fumiama/stm32-seesaw/Core/Src/main.c

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
/* Includes ------------------------------------------------------------------*/
#include "main.h"

/* USER CODE BEGIN Includes */
#include <stdio.h>
#include <math.h>
/* USER CODE END Includes */

/* USER CODE BEGIN PD */
#define GY_ACC 0x15
#define GY_RO  0x25
#define GY_MG  0x35
#define GY_EUR 0x45
#define GY_4P  0x65
#define GY_ACF 0x75
#define GY_RNG 0x85

#define GY_T_ACC "\xa5\x15\xba"
#define GY_T_RO  "\xa5\x25\xca"
#define GY_T_MG  "\xa5\x35\xda"
#define GY_T_EUR "\xa5\x45\xea"
#define GY_T_4P  "\xa5\x65\x0a"

#define GY_G_RO  "\xa5\xd5\x7a"
#define GY_G_MG  "\xa5\xe5\x8a"
#define GY_G_EUR "\xa5\x95\x3a"

#define GY_FIX_ACC "\xa5\x57\xfc"
#define GY_FIX_MG  "\xa5\x58\xfd"

#define GY_SPED_50 "\xa5\xa4\x49"

#define CMD_FRNT  '^'
#define CMD_BACK  'v'
#define CMD_LEFT  '<'
#define CMD_RGHT  '>'
#define CMD_STAT  '#'
#define CMD_STOP  '-'
#define CMD_LOCK  '+'

#define RO_RATE CIRCLE_TICKS

#define CALC_SPEED_PIHEDGE 16

#define PID_KP 0.04f
#define PID_KI 0.0f
#define PID_KD 0.09f
#define PID_KPS 0.03f
#define PID_KIS 0.0f
#define PID_KDS 0.08f
/* USER CODE END PD */

TIM_HandleTypeDef htim1;

UART_HandleTypeDef huart1;
UART_HandleTypeDef huart2;

/* USER CODE BEGIN PV */
uint8_t     USART1_SendBuff[USART1_SEND_LEN_MAX];
uint8_t     USART1_RecvBuff[USART1_RECV_LEN_MAX];
uint8_t     UserRecvBuff1[USART1_RECV_LEN_MAX];

uint8_t     USART2_SendBuff[USART2_SEND_LEN_MAX];
uint8_t     USART2_RecvBuff[USART2_RECV_LEN_MAX];
//uint8_t     UserRecvBuff2[USART2_RECV_LEN_MAX];

/**********GY953的相关变量*********/
/*
int16_t   AccX       = 0;		//加速度值
int16_t   AccY       = 0;
int16_t   AccZ       = 0;

int16_t   GyroX      = 0;		//陀螺仪值
// y 小于 0 说明有向下转动的角加速度
int16_t   GyroY      = 0;
int16_t   GyroZ      = 0;

int16_t   MgX	    	 = 0;   //地磁计值
int16_t   MgY        = 0;
int16_t   MgZ        = 0;

int16_t   Roll       = 0;		//欧拉角值*100
*/
// pitch 小于 0 说明向下倾斜
//int16_t   Pitch      = 0;
//int16_t   Yaw        = 0;

BTSTAT bs;
int16_t speed1 = 50, speed2 = 24, tick = CIRCLE_TICKS-64, eurcntr = 0;
uint8_t isunstable = 0, isinpid = 0, isinit = 0;
static uint8_t isonexit = 0, isindiradj = 1;
static int16_t pmid = 0, pgnd = 0, ymid = 0, prevp = 0;
/* USER CODE END PV */

void SystemClock_Config(void);
static void MX_GPIO_Init(void);
static void MX_TIM1_Init(void);
static void MX_USART1_UART_Init(void);
static void MX_USART2_UART_Init(void);
/* USER CODE BEGIN PFP */
static int16_t Calc_PID(int16_t y);
static int Calc_Speed(int16_t y);
static int Calc_Direction(int16_t z);
/* USER CODE END PFP */

/**
  * @brief  The application entry point.
  * @retval int
  */
int main(void)
{
  /* MCU Configuration--------------------------------------------------------*/

  /* Reset of all peripherals, Initializes the Flash interface and the Systick. */
  HAL_Init();

  /* Configure the system clock */
  SystemClock_Config();

  /* Initialize all configured peripherals */
  MX_GPIO_Init();
  MX_TIM1_Init();
  MX_USART1_UART_Init();
  MX_USART2_UART_Init();
  /* USER CODE BEGIN 2 */
  HAL_TIM_PWM_Start(&htim1, TIM_CHANNEL_1);
  HAL_TIM_PWM_Start(&htim1, TIM_CHANNEL_4);
  
  // UART1 串口1 开启接收中断，存到USART1_RecvBuff中，最大长度为 USART1_RECV_LEN_MAX
  // 即，接收了 USART1_RECV_LEN_MAX 个数据之后，产生中断
  // 中断将会触发 HAL_UART_RxCpltCallback 串口接收中断处理函数    
  HAL_UART_Receive_IT(&huart1, (uint8_t *)USART1_RecvBuff, USART1_RECV_LEN_MAX);
  // UART2 串口2 同理
  HAL_UART_Receive_IT(&huart2, (uint8_t *)USART2_RecvBuff, USART2_RECV_LEN_MAX);

  MotoCtrl_SetValue(0, MOTOR_ALL);
  HAL_Delay(1024);
  GY_UART_Init();
  /* USER CODE END 2 */

  /* Infinite loop */
  /* USER CODE BEGIN WHILE */
  while (1) {
    /* USER CODE END WHILE */

    /* USER CODE BEGIN 3 */
    __WFI();
  }
  /* USER CODE END 3 */
}

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
/* USER CODE BEGIN 4 */
/* ！！！！！！！！务必在  USER CODE BEGIN  和 USER CODE END 之间添加用户程序！！！！！！！！*/
/* ！！！！！！！！！而且不要改动   USER CODE BEGIN 4   之类的标记！！！！！！！！！！！！！*/
//
// MotoCtrl_SetValue 圆周舵机的转速控制设置函数
//
// value 转速设置值，-200 ~ 200，大约在 0 左右转速为 0
//       正转，反转
//       如果超出 -200 ~ 200 范围，不进行设置
//
// motor 电机号，MOTOR_1 或 MOTOR_2，在main.h中有定义
//       MOTOR_1 用的是htim1的TIM_CHANNEL_1，用 PA8 端口
//       MOTOR_2 用的是htim1的TIM_CHANNEL_4，用 PA11 端口
static TIM_OC_InitTypeDef sConfig = {TIM_OCMODE_PWM1, 0, TIM_OCPOLARITY_HIGH, TIM_OCNPOLARITY_HIGH, TIM_OCFAST_DISABLE, TIM_OCIDLESTATE_RESET, TIM_OCNIDLESTATE_RESET};
void MotoCtrl_SetValue(int16_t value, int16_t motor) {
    // 转速设置范围判断
    if ((value>200)||(value<-200)) return;
    TIM_OC_InitTypeDef sConfigOC = sConfig;

    if ( motor==MOTOR_2 || !~motor ){
      // 实际设置PWM的值是 100 - 500
      sConfigOC.Pulse = value+300;
      HAL_TIM_PWM_Stop(&htim1, TIM_CHANNEL_1);
    	if (HAL_TIM_PWM_ConfigChannel(&htim1, &sConfigOC, TIM_CHANNEL_1) != HAL_OK) Error_Handler();
    	HAL_TIM_PWM_Start(&htim1, TIM_CHANNEL_1);
    }

    if ( motor==MOTOR_1 || !~motor ){
      // 实际设置PWM的值是 100 - 500
      sConfigOC.Pulse = -value+300;
    	HAL_TIM_PWM_Stop(&htim1, TIM_CHANNEL_4);
      if (HAL_TIM_PWM_ConfigChannel(&htim1, &sConfigOC, TIM_CHANNEL_4) != HAL_OK) Error_Handler();
      HAL_TIM_PWM_Start(&htim1, TIM_CHANNEL_4);
    }
}

void GY_UART_Init(void) {
  HAL_UART_Transmit_IT(&huart1,  (uint8_t*)(GY_T_EUR GY_FIX_ACC), sizeof(GY_T_EUR GY_FIX_ACC)-1);
  HAL_UART_Transmit_IT(&huart2, (uint8_t*)"[Init] GY to eur.\n", 18);
}

void GY_UART_Switch(void) {
  HAL_UART_Transmit_IT(&huart1, (uint8_t*)(GY_T_EUR GY_T_RO), sizeof(GY_T_EUR GY_T_RO)-1);
}

void GY_UARTPackage_Unpack(void) {
  static int16_t stables = 0;
  static uint8_t not_frist_init = 0;
  GY953Frame* gf = (GY953Frame*)UserRecvBuff1;
  unsigned char s = 0;
  for(s = 0; s < USART1_RECV_LEN_MAX-5; s++) {
    if(gf->Head != 0x5a5a) gf = (GY953Frame*)(UserRecvBuff1+s);
    else break;
  }
  if(s == USART1_RECV_LEN_MAX-5) return;
  unsigned char* rawd = gf->RawData;
  int16_t speed, tmod;
  char sndbuf[256];
  sndbuf[0] = 0;
  //int16_t X = __builtin_bswap16(*(uint16_t*)(rawd));
  int16_t Y = __builtin_bswap16(*(uint16_t*)(rawd+2));
  int16_t Z = __builtin_bswap16(*(uint16_t*)(rawd+4));
  switch(gf->Type) {
    case GY_ACC:
      //AccX = X; AccY = Y; AccZ = Z;
      //HAL_UART_Transmit_IT(&huart2, (uint8_t*)"recv acc.\n", 10);
    break;
    case GY_RO:
      //GyroX = X; GyroY = Y; GyroZ = Z;
      //HAL_UART_Transmit_IT(&huart2, (uint8_t*)"recv ro.\n", 9);
      if(!isinit) return;
      if(!isinpid) {
        if(Y>RO_RATE||Y<-RO_RATE) {
          stables = 0;
          if(!isunstable) {
            isunstable = 1;
            MotoCtrl_SetValue(0, MOTOR_ALL);
            HAL_UART_Transmit_IT(&huart2, (uint8_t*)"[State] unstable.\n", 18);
            if(!not_frist_init) not_frist_init = 1;
            tick = CIRCLE_TICKS-64;
          }
        } else if(isunstable) {
          if(stables++>64) {
            isunstable = stables =  0;
            HAL_UART_Transmit_IT(&huart2, (uint8_t*)"[State] stable.\n", 16);
          }
        } else if(not_frist_init && !bs.isstarted) {
          tmod = tick++&(CIRCLE_TICKS-1);
          if(tmod==CIRCLE_TICKS>>1) {
            MotoCtrl_SetValue(0, MOTOR_ALL);
            sprintf(sndbuf, "[GyUR] stop motor.\n");
          } else if(tmod==CIRCLE_TICKS-64) {
            GY_UART_Switch();  // 切换到 EUR
            sprintf(sndbuf, "[GyUR] switch to eur.\n");
          }
        }
      }
    break;
    case GY_MG:
      //MgX = X; MgY = Y; MgZ = Z;
      //HAL_UART_Transmit_IT(&huart2, (uint8_t*)"recv mg.\n", 9);
    break;
    case GY_EUR:
      //Roll = X; Pitch = Y; Yaw = Z;
      if(isonexit) {
        if(~isonexit) {
          if(isonexit>64) {
            tmod = Y-pgnd;
            if(tmod>-4&&tmod<4) {
              tmod = 0;
              isonexit = -1;
              speed1 = 50; speed2 = 24;
              MotoCtrl_SetValue(0, MOTOR_ALL);
              sprintf(sndbuf, "[GyUR] program finished.\n");
            }
          } else isonexit++;
        } else HAL_GPIO_TogglePin(LED_IDC_GPIO_Port, LED_IDC_Pin); // 灯闪
      }
      if(!isinit) {
        if(~eurcntr) {
          if(!eurcntr) {
            if(Y) eurcntr++;
          }
          if(eurcntr) {
            if(eurcntr == 64) {
              pmid = Y; ymid = Z;
              sprintf(sndbuf, "[GyUR] init pmid: %d, ymid: %d.\n", Y, Z);
            } else if(eurcntr > 64) {
              pmid = (pmid+Y)/2;
              ymid = (ymid+Z)/2;
            }
            if(eurcntr++>128) {
              pgnd = pmid;
              sprintf(sndbuf, "[GyUR] fin pmid: %d, ymid: %d.\n", pmid, ymid);
              HAL_GPIO_TogglePin(LED_IDC_GPIO_Port, LED_IDC_Pin); // 灯灭
              eurcntr = -1;
            }
          }
        }
      }
      else if(isindiradj) {
        if(Y-pmid>256) { // 抬头
          if(Calc_Direction(Z)) { // 回归正向
            isindiradj = 0;
            GY_UART_Switch(); // 切换到 RO
            sprintf(sndbuf, "[GyUR] quit dir, switch to ro.\n");
          }
          MotoCtrl_SetValue(speed1, MOTOR_1);
          MotoCtrl_SetValue(speed2, MOTOR_2);
        }
      }
      else if(isinpid) {
        speed = Calc_PID(Y);
        if(speed>-8&&speed<8) {
          if(stables++>500) { // 保持 10s
            isinpid = stables = isinit = prevp = 0;
            isonexit = 1;
            speed1 = 50; speed2 = 24;
            MotoCtrl_SetValue(-speed1, MOTOR_1);
            MotoCtrl_SetValue(-speed2, MOTOR_2);
            sprintf(sndbuf, "[GyUR] quit pid, on exit.\n");
          }
          HAL_GPIO_TogglePin(LED_IDC_GPIO_Port, LED_IDC_Pin); // 灯闪
        } else {
          stables = 0;
          sprintf(sndbuf, "[GyUR] speed: %d.\n", speed);
          if(speed>10||speed<-10) {
            MotoCtrl_SetValue(speed, MOTOR_ALL);
          } else {
            MotoCtrl_SetValue(speed+4, MOTOR_1);
            MotoCtrl_SetValue(speed-4, MOTOR_2);
          }
        }
      }
      else if(not_frist_init && !bs.isstarted && !isunstable) {
        tmod = tick++&(CIRCLE_TICKS-1);
        if(!tmod) {
          isinpid = Calc_Speed(Y);
          if(!isinpid) {
            GY_UART_Switch();  // 切换到 RO
            MotoCtrl_SetValue(speed1, MOTOR_1);
            MotoCtrl_SetValue(speed2, MOTOR_2);
            sprintf(sndbuf, "[GyUR] switch to ro.\n");
          } else {
            MotoCtrl_SetValue(0, MOTOR_ALL);
            stables = 0;
            sprintf(sndbuf, "[GyUR] enter into pid.\n");
          }
        }
      }
      //HAL_UART_Transmit_IT(&huart2, (uint8_t*)"recv eur.\n", 10);
    break;
    default: break;
  }
  int sndlen = strlen(sndbuf) + 1;
  if(sndlen > 1) HAL_UART_Transmit_IT(&huart2, (uint8_t*)sndbuf, sndlen);
}

static int16_t Calc_PID(int16_t y) {
  static int16_t prev_dy = 0, int_sum = 0;
  static uint8_t stables = 0;
  int16_t dy = y - pmid, out;
  int_sum += dy;
  if(stables>128) {
    out = PID_KPS*(float)dy + PID_KIS*(float)int_sum + PID_KDS*(float)(dy-prev_dy);
  } else {
    out = PID_KP*(float)dy + PID_KI*(float)int_sum + PID_KD*(float)(dy-prev_dy);
    if(out>=-2&&out<=2) stables++;
    else stables = 0;
  }
  prev_dy = dy;
  return out;
}

static int Calc_Direction(int16_t z) {
  int16_t ds, s1, s2, dz = z-ymid;
  if(dz>-16&&dz<16) {
    speed1 = 50; speed2 = 24;
    return 1;
  }
  if(dz>0) {
    ds = 1.2*sqrt(dz);
    s1 = -ds+20;
    s2 = ds+20;
  } else {
    ds = 1.2*sqrt(-dz);
    s1 = ds+20;
    s2 = -ds+20;
  }
  ds = s1-speed1;
  if(ds>10) speed1 += 10;
  else if(ds<-10) speed1 -= 10;
  ds = s2-speed2;
  if(ds>10) speed2 += 10;
  else if(ds<-10) speed2 -= 10;
  return 0;
}

int Calc_Speed(int16_t y) {
  char sndbuf[256];
  sndbuf[0] = 0;
  if(!prevp) prevp = y;
  else {
    pmid = (prevp+y)/2;
    prevp = y;
    return 1;
  }
  int16_t dp = y-pmid;
  y = 0;
  int16_t d1 = 0, d2 = 0;
  if(dp<-CALC_SPEED_PIHEDGE||dp>CALC_SPEED_PIHEDGE) {
    if(dp > 0) {
      d1=50; d2=24;
    }
    else {
      d1=-50; d2=-24;
    }
  }
  speed1 = d1;
  speed2 = d2;
  sprintf(sndbuf, "[Calc] pmid: %d, dp: %d.\n", pmid, dp);
  int sndlen = strlen(sndbuf) + 1;
  if(sndlen > 1) HAL_UART_Transmit_IT(&huart2, (uint8_t*)sndbuf, sndlen);
  return 0;
}

void Bluetooth_Recv(uint8_t cmd) {
  if(bs.isstarted) {
    switch(cmd) {
      case CMD_FRNT: MotoCtrl_SetValue(bs.speed, MOTOR_ALL); break;
      case CMD_BACK: MotoCtrl_SetValue(-bs.speed, MOTOR_ALL); break;
      case CMD_LEFT: MotoCtrl_SetValue(bs.speed>>1, MOTOR_1); MotoCtrl_SetValue(bs.speed, MOTOR_2); break;
      case CMD_RGHT: MotoCtrl_SetValue(bs.speed, MOTOR_1); MotoCtrl_SetValue(bs.speed>>1, MOTOR_2); break;
      case CMD_STOP: if(bs.cmd != CMD_STOP) MotoCtrl_SetValue(0, MOTOR_ALL); else bs.isstarted = 0; break;
      case CMD_LOCK: bs.islocked = ~bs.islocked; break;
      default: bs.speed = ((int)cmd)<<1; break;
    }
  } else if(cmd == CMD_STAT) {
    bs.isstarted = 1;
    bs.speed = 50;
    MotoCtrl_SetValue(50, MOTOR_ALL);
  }
  bs.cmd = cmd;
}
/* USER CODE END 4 */
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
