fumiama/stm32-seesaw/Core/Inc/main.h

#define LED_IDC_Pin GPIO_PIN_13
#define LED_IDC_GPIO_Port GPIOC
#define UKEY_Pin GPIO_PIN_0
#define UKEY_GPIO_Port GPIOA
#define UKEY_EXTI_IRQn EXTI0_IRQn
#define MotorCtrl1_Pin GPIO_PIN_8
#define MotorCtrl1_GPIO_Port GPIOA
#define MotorCtrl2_Pin GPIO_PIN_11
#define MotorCtrl2_GPIO_Port GPIOA
#define USART1_SEND_LEN_MAX        16     // 串口 1 发送缓冲区的最大长度
#define USART1_RECV_LEN_MAX        22
#define USART2_SEND_LEN_MAX        16     // 串口 2 发送缓冲区的最大长度
#define USART2_RECV_LEN_MAX        1
#define MOTOR_ALL   -1
#define MOTOR_1	    0
#define MOTOR_2	    1
#define CIRCLE_TICKS 256
