fumiama/stm32-seesaw/(commit log)

2021-11-18 add pid
2021-11-19 fix pid
2021-11-23 add uart1 desc
